Arthrimus/BlueRetro-HW2-GameCube/PCB/GC BlueRetro BOM (Port Shield).xlsx

Comment | Designator | Footprint | LCSC Part #（optional）
10k | R5 | R_0603
64.9R | R3 | R_0603
10k | R2,R12,R22,R32 | R_0603
Blue | D1 | R_1206
ESP32-WROOM-32UE | U5 | C701344
