Arthrimus/BlueRetro-HW2-GameCube/PCB/GC BlueRetro BOM (Current Trigger).xlsx

Comment | Designator | Footprint | LCSC Part #（optional）
10k | R5 | R_0603
4.7k | R1,R11,R21,R31 | R_0603
64.9R | R3 | R_0603
100k | R2,R12,R22,R32 | R_0603
Blue | D1 | R_1206
YJS2301A | Q1,Q11,Q21,Q31 | SOT-23-6
BSS123 | Q2,Q12,Q22,Q32 | SOT-23
ESP32-WROOM-32UE | U5 | C701344
