Arthrimus/BlueRetro-HW2-GameCube/(list of files, drawings)

Other design files:
PCB/GC BlueRetro.dch
PCB/GC BlueRetro.dip
