Arthrimus/BlueRetro-HW2-GameCube/(threads)

Thread 1 (2024-08-22):

add individual port connection lighting indicators

Colrut, 2024-08-22:
Just discovered this project - it looks great.

In a future version of the board, can you add soldering pads/points that connect to pins 2, 4, 12, and 15 along with a ground for each of these.  This would allow adding LED lights to each of the ports to indicate their status.

The pictures show a sample install with developer board (HW1 spec).  Note that I group the grounds into one wire.  Many installs will use pre-wired LED so having separate grounds might be better for most installers.

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
